ashwin524524/LKS_BLDC_Controller/README.md

A low cost, accessible FOC motor controller for small robotics applications. Rated for ~50v and 40A.
