ashwin524524/LKS_BLDC_Controller/erc_report.txt

ERC report (2026-10-25T21:55:01, Encoding UTF8)
Report includes: Errors, Warnings

***** Sheet /

***** Sheet /PWR&MOS/

***** Sheet /Power_Supply/

 ** ERC messages: 0  Errors 0  Warnings 0

 ** Ignored checks:
    - Global label only appears once in the schematic
    - Four connection points are joined together
    - SPICE model issue
    - Assigned footprint doesn't match footprint filters
