ashwin524524/LKS_BLDC_Controller/LKS_Controller.kicad_pcb

## KiCad design LKS_Controller.kicad_pcb (2026-10-26)

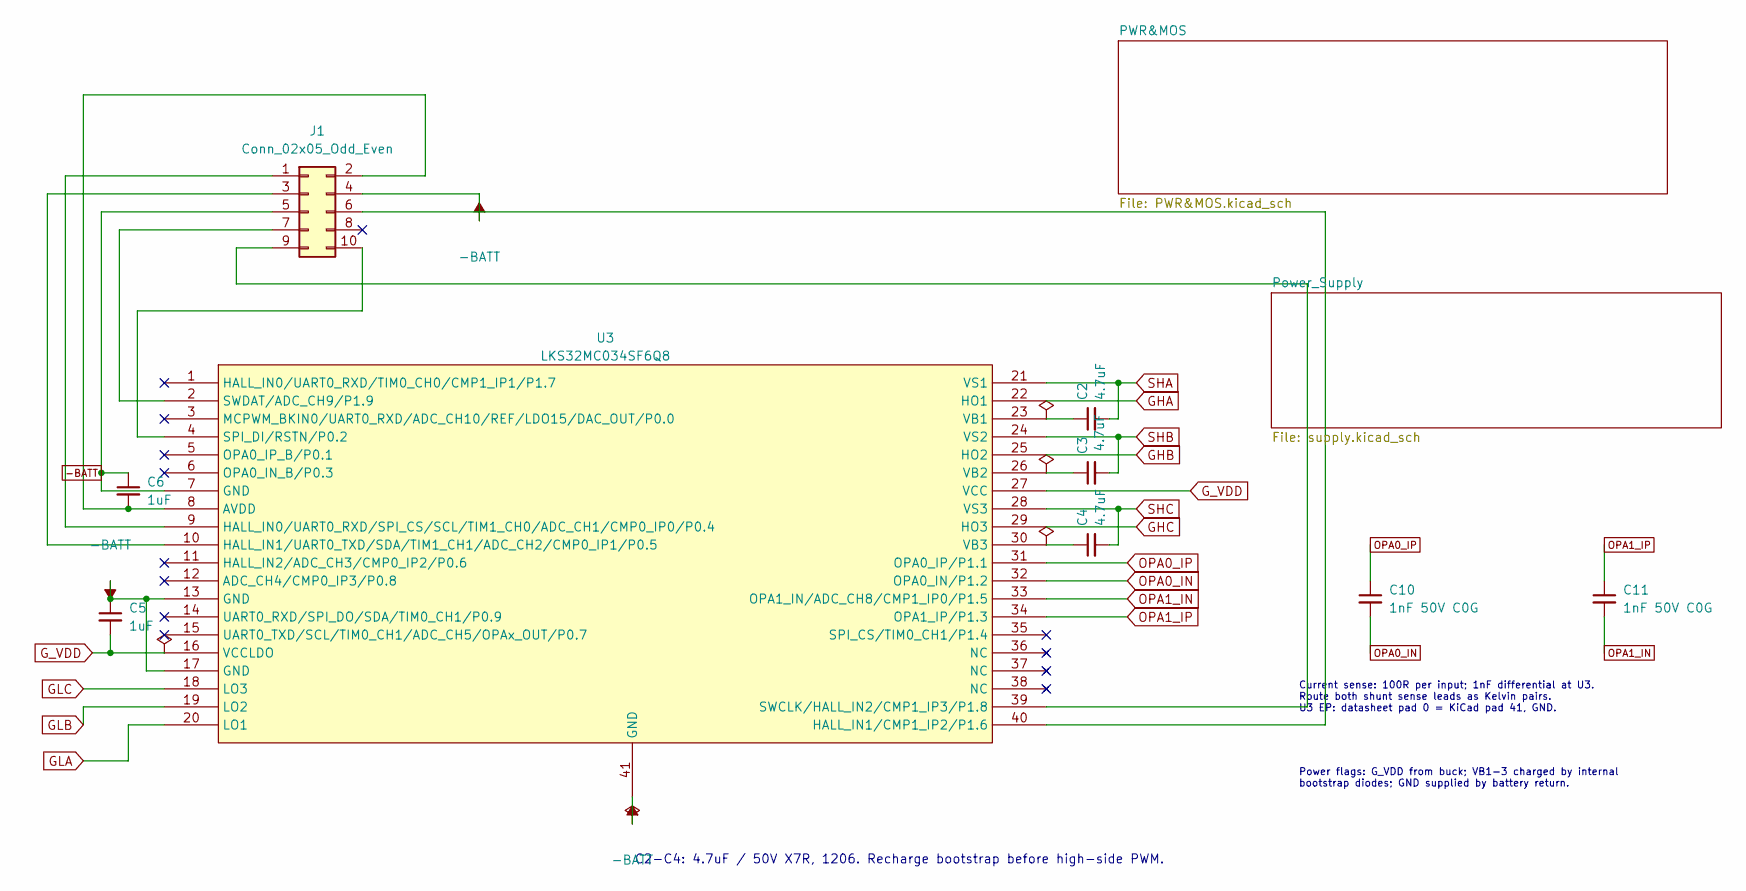
[picture p1: schematic LKS_Controller.kicad_sch]

Parts:
C2, C3, C4: 4.7uF; C_1206_3216Metric_Pad1.33x1.80mm_HandSolder; Tolerance 10%; Voltage 50V; MPN CC1206KKX7R9BB475; LCSC C132170
C5, C6: 1uF; C_0603_1608Metric_Pad1.08x0.95mm_HandSolder
C10, C11: 1nF 50V C0G; C_0603_1608Metric_Pad1.08x0.95mm_HandSolder; MPN CC0603KRNPO9BN102; LCSC C3909020
J1: Conn_02x05_Odd_Even; PinSocket_2x05_P2.54mm_Vertical
U3: LKS32MC034SF6Q8; QFN-40-1EP_5x5mm_P0.4mm_EP3.6x3.6mm_ThermalVias; MPN LKS32MC034SF6Q8; LCSC C19193083

Connections:
-BATT: C5.1, C6.1, J1.4, J1.5, U3.7 (GND), U3.13 (GND), U3.17 (GND), U3.41 (GND); also elsewhere on the board
GHA: U3.22 (HO1); also elsewhere on the board
GHB: U3.25 (HO2); also elsewhere on the board
GHC: U3.29 (HO3); also elsewhere on the board
GLA: U3.20 (LO1); also elsewhere on the board
GLB: U3.19 (LO2); also elsewhere on the board
GLC: U3.18 (LO3); also elsewhere on the board
G_VDD: C5.2, U3.16 (VCCLDO), U3.27 (VCC); also elsewhere on the board
unnamed: J1.1, U3.9 (HALL_IN0/UART0_RXD/SPI_CS/SCL/TIM1_CH0/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)
unnamed: C6.2, J1.2, U3.8 (AVDD)
unnamed: J1.3, U3.10 (HALL_IN1/UART0_TXD/SDA/TIM1_CH1/ADC_CH2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)
unnamed: J1.6, U3.40 (HALL_IN1/CMP1_IP2/P1.6)
unnamed: J1.7, U3.2 (SWDAT/ADC_CH9/P1.9)
unnamed: J1.9, U3.39 (SWCLK/HALL_IN2/CMP1_IP3/P1.8)
unnamed: J1.10, U3.4 (SPI_DI/RSTN/P0.2)
unnamed: C2.1, U3.23 (VB1)
unnamed: C3.1, U3.26 (VB2)
unnamed: C4.1, U3.30 (VB3)
OPA0_IN: C10.2, U3.32 (OPA0_IN/P1.2); also elsewhere on the board
OPA0_IP: C10.1, U3.31 (OPA0_IP/P1.1); also elsewhere on the board
OPA1_IN: C11.2, U3.33 (OPA1_IN/ADC_CH8/CMP1_IP0/P1.5); also elsewhere on the board
OPA1_IP: C11.1, U3.34 (OPA1_IP/P1.3); also elsewhere on the board
SHA: C2.2, U3.21 (VS1); also elsewhere on the board
SHB: C3.2, U3.24 (VS2); also elsewhere on the board
SHC: C4.2, U3.28 (VS3); also elsewhere on the board

Notes on the sheet:
C2-C4: 4.7uF / 50V X7R, 1206. Recharge bootstrap before high-side PWM.
Current sense: 100R per input; 1nF differential at U3. Route both shunt sense leads as Kelvin pairs. U3 EP: datasheet pad 0 = KiCad pad 41, GND.
Power flags: G_VDD from buck; VB1-3 charged by internal bootstrap diodes; GND supplied by battery return.

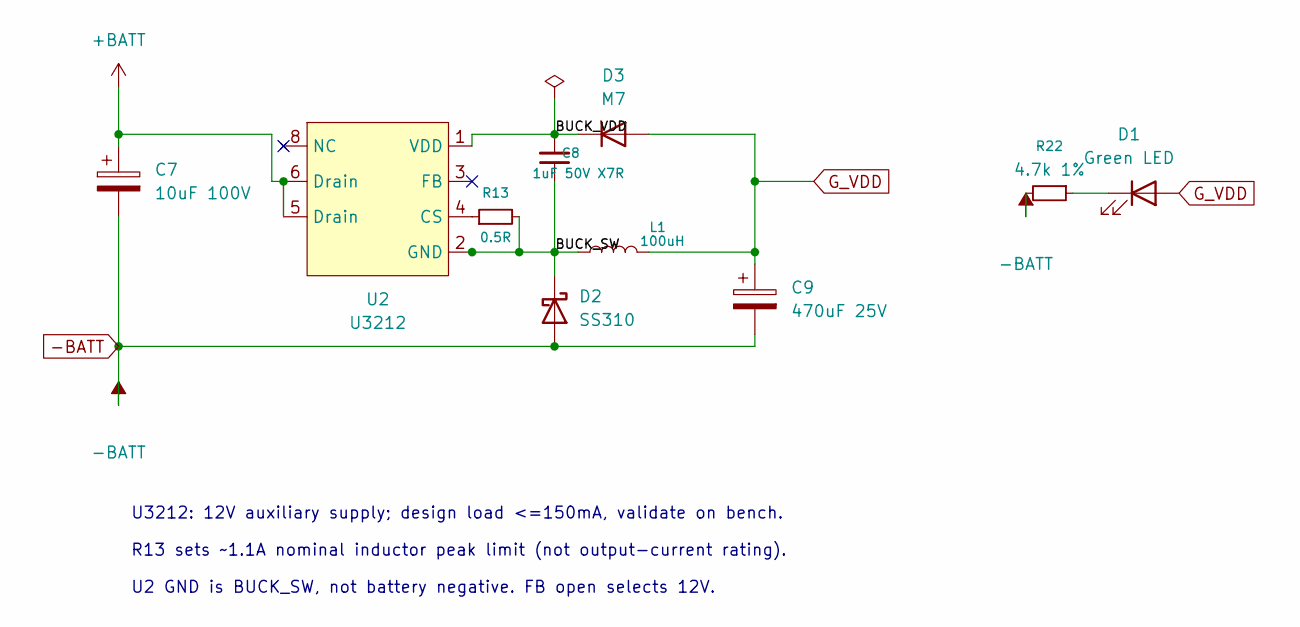
[picture p2: schematic supply.kicad_sch]

Parts:
C7: 10uF 100V; C_Radial_D6.3mm_H11.0mm_P2.50mm; MPN ERS1KM100E11OT; LCSC C106677
C8: 1uF 50V X7R; C_0805_2012Metric_Pad1.18x1.45mm_HandSolder; MPN TCC0805X7R105M500FT; LCSC C376929
C9: 470uF 25V; C_Radial_D8.0mm_H12.0mm_P3.50mm; MPN 01EC1227SHC470UF25V; LCSC C503221
D1: Green LED; LED_0603_1608Metric_Pad1.05x0.95mm_HandSolder; MPN 19-217/GHC-YR1S2/3T; LCSC C72043
D2: SS310; D_SMA; MPN SS310; LCSC C513470
D3: M7; D_SMA; MPN M7; LCSC C266550
L1: 100uH; L_XR_XR0650; MPN XR0650-101M; LCSC C5358146
R13: 0.5R; R_1206_3216Metric_Pad1.30x1.75mm_HandSolder; MPN HP06W2F500LT5E; LCSC C2759131
R22: 4.7k 1%; R_0603_1608Metric_Pad0.98x0.95mm_HandSolder; MPN 0603WAF4701T5E; LCSC C23162
U2: U3212; U3212_SOP-7_3.9x4.9mm_P1.27mm; MPN U3212; LCSC C2874740

Connections:
+BATT: C7.1, U2.5 (Drain), U2.6 (Drain); also elsewhere on the board
-BATT: C7.2, C9.2, D2.2 (A), R22.2; also elsewhere on the board
/Power_Supply/BUCK_SW: C8.1, D2.1 (K), L1.1, R13.2, U2.2 (GND)
/Power_Supply/BUCK_VDD: C8.2, D3.1 (K), U2.1 (VDD)
G_VDD: C9.1, D1.2 (A), D3.2 (A), L1.2; also elsewhere on the board
unnamed: D1.1 (K), R22.1
unnamed: R13.1, U2.4 (CS)

Notes on the sheet:
U3212: 12V auxiliary supply; design load <=150mA, validate on bench.
R13 sets ~1.1A nominal inductor peak limit (not output-current rating).
U2 GND is BUCK_SW, not battery negative. FB open selects 12V.

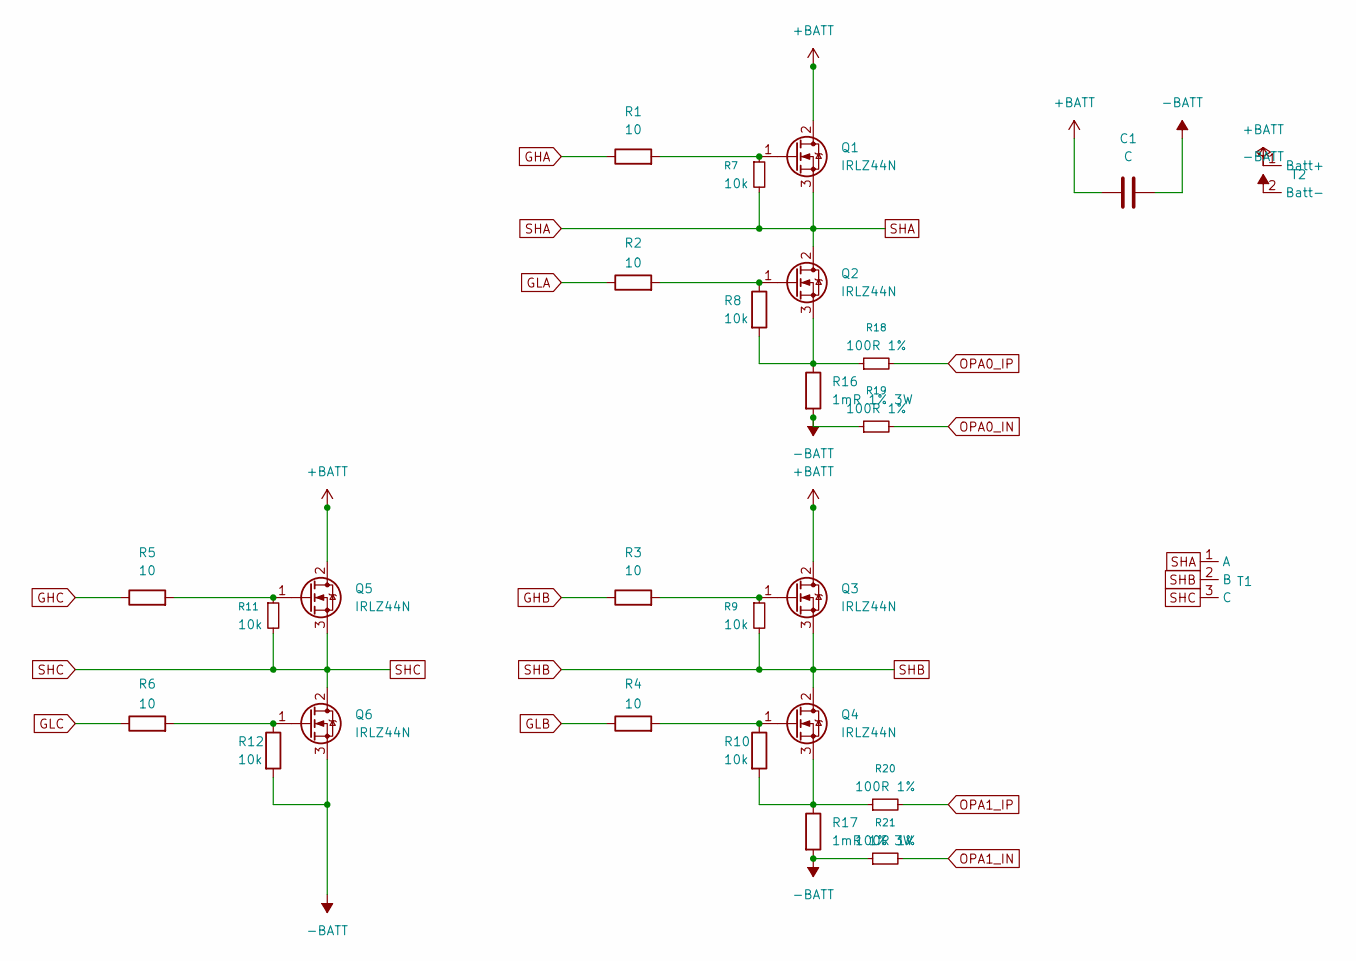
[picture p3: schematic PWR&MOS.kicad_sch]

Parts:
C1: C; C_Radial_P5mm_AsRouted
Q1, Q2, Q3, Q4, Q5, Q6: IRLZ44N; TO-220-3_Vertical
R1, R2, R3, R4, R5, R6: 10; R_1206_3216Metric_Pad1.30x1.75mm_HandSolder
R7, R8, R9, R10, R11, R12: 10k; R_0402_1005Metric_Pad0.72x0.64mm_HandSolder; Tolerance 1%; MPN 0402WGF1002TCE; LCSC C25744
R16, R17: 1mR 1% 3W; R_2512_6332Metric; MPN HoJLR2512-3W-1mR-1%; LCSC C2903470
R18, R19, R20, R21: 100R 1%; R_0603_1608Metric_Pad0.98x0.95mm_HandSolder; MPN 0603WAF1000T5E; LCSC C22775
T1: ABC_Terminal
T2: Battery_Wire_Pads_P10mm

Connections:
+BATT: C1.1, Q1.2 (D), Q3.2 (D), Q5.2 (D), T2.1 (Batt+); also elsewhere on the board
-BATT: C1.2, Q6.3 (S), R12.2, R16.2, R17.2, R19.1, R21.1, T2.2 (Batt-); also elsewhere on the board
GHA: R1.1; also elsewhere on the board
GHB: R3.1; also elsewhere on the board
GHC: R5.1; also elsewhere on the board
GLA: R2.1; also elsewhere on the board
GLB: R4.1; also elsewhere on the board
GLC: R6.1; also elsewhere on the board
unnamed: Q1.1 (G), R1.2, R7.1
unnamed: Q2.1 (G), R2.2, R8.1
unnamed: Q2.3 (S), R8.2, R16.1, R18.1
unnamed: Q3.1 (G), R3.2, R9.1
unnamed: Q4.1 (G), R4.2, R10.1
unnamed: Q4.3 (S), R10.2, R17.1, R20.1
unnamed: Q5.1 (G), R5.2, R11.1
unnamed: Q6.1 (G), R6.2, R12.1
OPA0_IN: R19.2; also elsewhere on the board
OPA0_IP: R18.2; also elsewhere on the board
OPA1_IN: R21.2; also elsewhere on the board
OPA1_IP: R20.2; also elsewhere on the board
SHA: Q1.3 (S), Q2.2 (D), R7.2, T1.1 (A); also elsewhere on the board
SHB: Q3.3 (S), Q4.2 (D), R9.2, T1.2 (B); also elsewhere on the board
SHC: Q5.3 (S), Q6.2 (D), R11.2, T1.3 (C); also elsewhere on the board

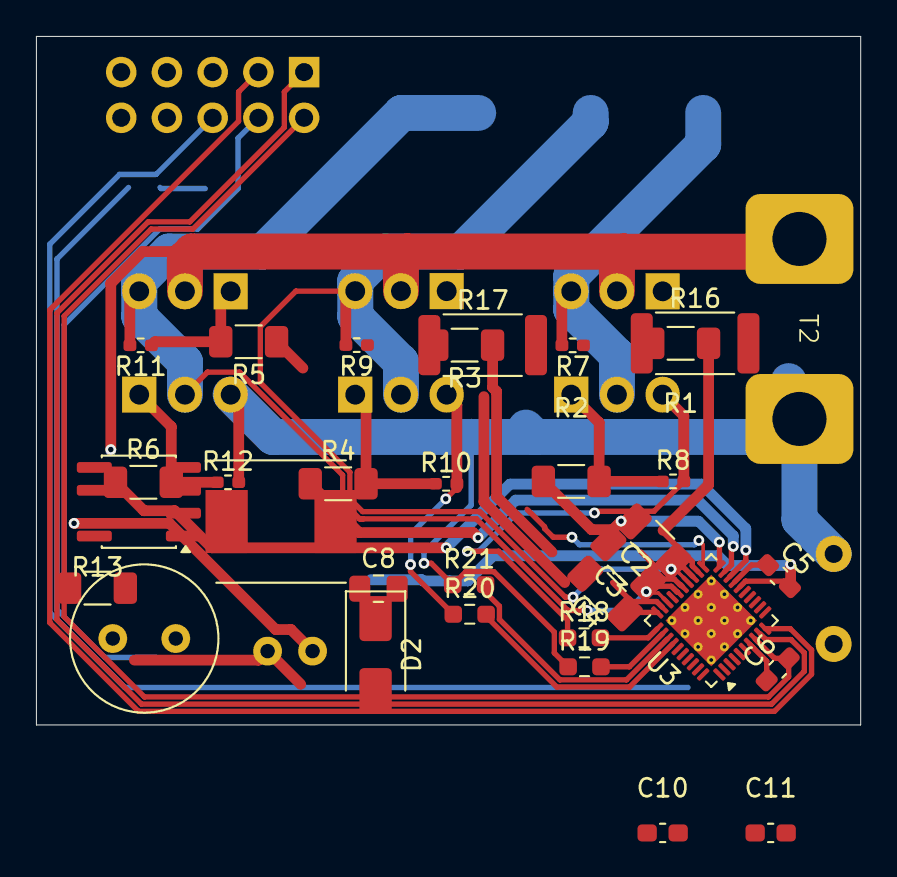
[picture p4: board LKS_Controller.kicad_pcb from above]

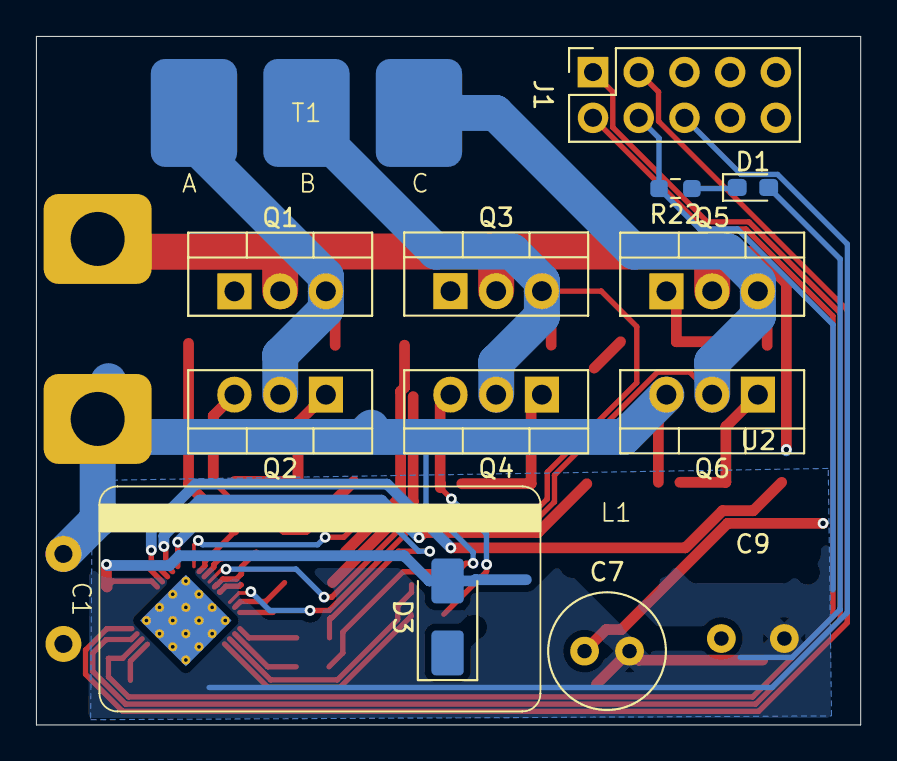
[picture p5: board LKS_Controller.kicad_pcb from below]

Board: 2 copper layers, 45.8 x 38.2 mm, 46 parts (13 on the bottom side), 38 nets.
