ashwin524524/LKS_BLDC_Controller/(commit log)

2026-08-10 first commit, loading files into git
    [LKS_Controller.kicad_pcb, LKS_Controller.kicad_sch, PWR&MOS.kicad_sch, supply.kicad_sch]
2026-08-12 updated layout, power supply schematic
    [LKS_Controller.kicad_pcb, PWR&MOS.kicad_sch, supply.kicad_sch]
2026-08-13 started routing
    [LKS_Controller.kicad_pcb]
2026-10-26 Fix ESC power, gate drive and current sensing schematics
    Correct the buck converter and MCU symbols, bootstrap networks, MOSFET pulldowns and current sensing components. Migrate project libraries, synchronize PCB footprints and ground nets, and resolve ERC errors and warnings. Include LCSC BOMs and design notes; PCB routing remains incomplete.
    [LKS_Controller.kicad_pcb, LKS_Controller.kicad_sch, PWR&MOS.kicad_sch, buck_converter_bom.csv, current_sense_bom.csv, gate_drive_bom.csv, supply.kicad_sch]
2026-10-26 Schematic sorted out, fixed power, bootstrap capac itors
